robaki-dev/robak/README.md

# Robak :bug:
Robak is a DIY 4x4 all-terrain radio controlled vehicle. Designed from scratch with makers in mind - you can build one yourself.

robak

### Printed parts :car:
- Download 3D models `.zip` package from [releases](https://github.com/robaki-dev/robak/releases)

### What to print :heavy_check_mark:
- Check the [3DPartsList](3DPartsList.csv)

### Non printed parts :rocket:
- Check the [BOM](BOM.csv)
- Links available on [Discord](https://discord.gg/4mxkpQYTXy)

### Hinge pins :scissors:
- Cut steel rods to lenght: [drawing](DRAWINGS/HingePins.pdf)

### Documentation :green_book:
- [Docs](https://robaki.dev/docs) on https://robaki.dev

### Support :wave:
- Join our [Discord](https://discord.gg/4mxkpQYTXy) channel

### Video guide :video_camera:
Video Guide (https://www.youtube.com/watch?v=374VbFoaV5E)
