robaki-dev/robak/RobakPartsList.xlsx

Sheet: Non Printed Parts
Robak v2.2.0 Parts Shopping List |  |  | Created by Googliola. Last update: 12.05.2023 draft by Milosz |  |  |  |  |  | Basic edition |  | Plus edition
Category | Qty | Part name | Model | UnitPrice CHF [incl.shipping] | URLs [contains affiliate links] | Required | Status | Notes | Pick | Total | Pick | Total
Electronics
 | 1 | Transmitter & Receiver | DumboRC X4 X6 X6P 2.4G 6CH Transmitter X6F | 35.00 | https://s.click.aliexpress.com/e/_DmUJbcJ | Recommended | To order | easy to setup includes LiPo | TRUE | 35.00 | TRUE | 35.00
 | 1 | Transmitter & Receiver | Flysky FS GT3B FS-GT3B 2.4G 3CH | 31.00 | https://s.click.aliexpress.com/e/_DkLOPvt (https://vi.aliexpress.com/item/32981512042.html) | Alternative | To order | most sophisticated RC for multiple models setup more extensive / many options requires 8 (!) AA batteries | FALSE | 0.00 | FALSE | 0.00
 | 1 | Transmitter & Receiver | Droyuke New GA-4H-TX 4CH 2.4GHz Remote Control | 14.00 | https://s.click.aliexpress.com/e/_DFrT7Rz | Alternative | To order | easy to setup requires 4 AAA batteries | FALSE | 0.00 | FALSE | 0.00
 | 1 | Transmitter & Receiver | Reely Gen4 Pistolengriff-Fernsteuerung 2,4 GHz | 26.00 | https://www.conrad.ch/de/p/reely-gen4-pistolengriff-fernsteuerung-2-4-ghz-anzahl-kanaele-4-inkl-empfaenger-2267650.html | Alternative | To order | Sprinkle-resistant receiver long range Conrad Not available in all countries | FALSE | 0.00 | FALSE | 0.00
 | 1 | Battery charger | IMAX B6 Lipo Balance Charger | 21.00 | https://s.click.aliexpress.com/e/_DBvB4rZ | Recommended | To order | More sophisticated but not too complicated comes with XT60 | FALSE | 0.00 | TRUE | 21.00
 | 1 | Battery charger | HTRC S680 80W 6A AC to DC Mini RC LiPo Charger | 28.00 | https://www.banggood.com/custlink/DGvWgwlU7y | Alternative | To order | Easy to use / little control / no storage comes with T-Plug | FALSE | 0.00 | FALSE | 0.00
 | 1 | Battery charger | VOLTCRAFT V-Charge Eco LiPo 2000 | 15.00 | https://www.conrad.ch/de/p/voltcraft-v-charge-eco-lipo-2000-modellbau-ladegeraet-230-v-2-a-lipo-1409523.html | Alternative | To order | + Very basic, ideal for beginners - no discharge, store function | TRUE | 15.00 | FALSE | 0.00
 | 1 | 2S Battery | Zeee LiPo Battery 2S 6000mAh 80C XT60 Plug | 28.00 | https://s.click.aliexpress.com/e/_DBv0vof | Recommended | To order | hard case: l=138mm; w=48mm +/- 2mm | TRUE | 28.00 | TRUE | 28.00
 | 1 | 3S Battery | TBD | 28.00 | TBD | Alternative | To order |  | FALSE | 0.00 | FALSE | 0.00
 | 1 | Motor & ESC | HobbyWing MAX10 60A + 3652 3300KV | 100.00 | TBD | Recommended | To order | best value in return for your money | FALSE | 0.00 | TRUE | 100.00
 | 1 | Motor & ESC | Racerstar 3660 Brushless Motor 60A ESC Waterproof w/ M0.6 Metal Gears | 44.00 | https://www.banggood.com/custlink/3mGW6fakTJ | Alternative | To order | budget option | TRUE | 44.00 | FALSE | 0.00
 | 1 | Motor & ESC | Rocket V2 3650 3250KV 60A ESC Waterproof | 52.00 | https://s.click.aliexpress.com/e/_DeiD7vh | Alternative | To order |  | FALSE | 0.00 | FALSE | 0.00
 | 1 | Motor & ESC | Rocket V2 3650 3250KV 60A ESC Waterproof with Programming Card | 58.00 | https://s.click.aliexpress.com/e/_DEkWwQB | Alternative | To order |  | FALSE | 0.00 | FALSE | 0.00
 | 1 | Servo | rc servo 20KG DS3218 or PRO | 12.00 | https://s.click.aliexpress.com/e/_DemKoQf | Recommended | To order | cheap, reliable metal gear ,inlcludes horn | TRUE | 12.00 | TRUE | 12.00
 | 1 | Servo | Waterproof Servo DSC45MG 45KG | 35.00 | https://s.click.aliexpress.com/e/_Dmd69uR | Not Recommended | To order | too expensive servo | FALSE | 0.00 | FALSE | 0.00
 | 1 | Motor fan | HSP 03300 Aluminum Heat Sink Cooling Fan | 4.00 | https://s.click.aliexpress.com/e/_DmSxqEB | Optional | To order | NOT compatible with Rocket V2 motors | FALSE | 0.00 | FALSE | 0.00
 | 1 | Motor fan | Metal Shell 3010 ESC Motor 30mm Cooling Fan | 9.00 | https://vi.aliexpress.com/item/1005003298884797.html | Optional | To order | Good quality but expensive Different Chassis Rear Plate required! Compatible with any motor (inc Rocket V2 ) | FALSE | 0.00 | FALSE | 0.00
RC Parts
 | 1 | wheels | HSP 88005 Monster Truck | 22.00 | https://www.aliexpress.com/item/32748779556.html | Recommended | To order | 128x65mm, includes tires | TRUE | 22.00 | TRUE | 22.00
 | 1 | wheels | HSP 88030 Monster Truck | 20.00 | https://www.aliexpress.com/item/1005004166815985.html | Alternative | To order | 128x65mm, includes tires | FALSE | 0.00 | FALSE | 0.00
 | 1 | wheels | Short Course Truck Tires / Type B | 25.00 | https://www.aliexpress.com/item/1005005050521051.html | Alternative | To order | 111x45mm, normal price 45 USD | FALSE | 0.00 | FALSE | 0.00
 | 1 | wheels | Rubber Sponge Tire | 26.00 | https://s.click.aliexpress.com/e/_DBg0Bcn | Alternative | To order |  | FALSE | 0.00 | FALSE | 0.00
 | 1 | wheels | INJORA 4PCS 110*48MM | 22.00 | https://s.click.aliexpress.com/e/_Dmc1OYb | Alternative | To order | INNER DIAMETER??? | FALSE | 0.00 | FALSE | 0.00
 | 1 | wheels | HSP94166 Buggy | 12.00 | https://www.aliexpress.com/item/32755525487.html | Alternative | To order |  | FALSE | 0.00 | FALSE | 0.00
 | 4 | Rims | printed rims | 0.00 | https://www.printables.com/model/155343-300-x-1925-rims-for-robak | Optional | N/A |  | FALSE | 0.00 | FALSE | 0.00
 | 2 | servo horn | 25T, 20 and 25mm ctc distance | 3.00 | https://www.aliexpress.com/item/4000024586812.html | Optional | To order | buy unless servo comes with a horn | FALSE | 0.00 | FALSE | 0.00
 | 1 | shocks (set of 4) | INJORA Aluminum Shock Absorber 100mm | 20.00 | https://s.click.aliexpress.com/e/_DlzZ8yb | Recommended | To order |  | TRUE | 20.00 | TRUE | 20.00
 | 2 | shocks (set of 2) | INJORA Built-in Spring Shock Absorber 100mm | 8.00 | https://s.click.aliexpress.com/e/_DdWDcBX | Not Recommended | To order | coilover shocks are better | FALSE | 0.00 | FALSE | 0.00
 | 1 | shocks (set of 4) | INJORA Built-in Spring Shock Absorber100 | 16.00 | https://s.click.aliexpress.com/e/_DlzZ8yb | Not Recommended | To order | coilover shocks are better | FALSE | 0.00 | FALSE | 0.00
 | 1 | springs (set of 4) | 5858 Traxxas | 6.00 | TBD | Recommended | To order | recommended as the stock springs are too soft | TRUE | 6.00 | TRUE | 6.00
 | 1 | harder springs | INJORA Metal Shock Springs Compression 60*15mm | 5.00 | https://s.click.aliexpress.com/e/_DeXwE1l | Optional | To order |  | FALSE | 0.00 | FALSE | 0.00
 | 2 | differential | HSP 02024 | 7.00 | https://www.aliexpress.com/item/32754240421.html | Recommended | To order |  | TRUE | 14.00 | TRUE | 14.00
 | 2 | differential main gear | HSP 02029 | 3.00 | https://www.aliexpress.com/item/32754204819.html | Optional | To order | in case you damage one | FALSE | 0.00 | FALSE | 0.00
 | 1 | front & rear gear | HSP 02030 & HSP 03015 | 8.00 | https://s.click.aliexpress.com/e/_DFBlChz | Recommended | To order | e-clips included | TRUE | 8.00 | TRUE | 8.00
 | 1 | front gear | HSP 02030 | 4.00 | https://vi.aliexpress.com/item/32750973022.html | Alternative | To order | e-clips and 2x bearings included | FALSE | 0.00 | FALSE | 0.00
 | 1 | rear gear | HSP 03015 | 4.00 | https://vi.aliexpress.com/item/33030608113.html | Alternative | To order | e-clips and 2x bearings included | FALSE | 0.00 | FALSE | 0.00
 | 2 | cvd (set of 2) | HSP 108015 | 7.00 | https://www.aliexpress.com/item/1005003412783326.html | Recommended | To order | 113 and 84mm length (see pic on AliE) | TRUE | 14.00 | TRUE | 14.00
 | 1 | wheel hex (set of 4) | HSP 122042 | 1.00 | https://www.aliexpress.com/item/32750184003.html | Recommended | To order |  | TRUE | 1.00 | TRUE | 1.00
 | 1 | cups (set of 2) | HSP 02016 | 2.00 | https://www.aliexpress.com/item/32753894250.html?spm=a2g0o.cart.0.0.47aa38da7Ji0gU&mp=1 | Recommended | To order |  | TRUE | 2.00 | TRUE | 2.00
 | 1 | servo links (set of 2) | HSP 02012 | 2.00 | https://www.aliexpress.com/item/32746589847.html | Recommended | To order | only one needed | TRUE | 2.00 | TRUE | 2.00
 | 1 | steering links (set of 2) | HSP 06016 | 2.00 | https://www.aliexpress.com/item/32755140656.html?spm=a2g0o.cart.0.0.448338da3W1Opf&mp=1 | Recommended | To order | one pair | FALSE | 0.00 | TRUE | 2.00
 | 1 | drive shaft | HSP 04003 | 3.00 | https://vi.aliexpress.com/item/32755258981.html | Recommended | To order |  | TRUE | 3.00 | TRUE | 3.00
 | 1 | spur gear 64T + pinion 17T | HSP 11184 + HSP 11181 | 3.00 | https://www.aliexpress.com/item/32806354242.html | Recommended | To order | 64T + 17T | TRUE | 3.00 | TRUE | 3.00
 | 1 | spur gear 64T + pinion 21T | HSP 11181 + HSP 11181 | 3.00 | https://www.aliexpress.com/item/32806354242.html | Alternative | To order | 64T + 21T | FALSE | 0.00 | FALSE | 0.00
 | 2 | ball head (set of 4) | HSP 06007 | 3.00 | https://www.aliexpress.com/item/32757503647.html | Recommended | To order | for shocks | TRUE | 6.00 | TRUE | 6.00
 | 1 | grub screws M4x4mm (set of 10) | HSP 02099 | 2.00 | https://www.aliexpress.com/item/32752216934.html | Optional | To order | those should come with cups - HSP 02016 | TRUE | 2.00 | TRUE | 2.00
 | 1 | ball head screws (set of 6) | HSP 02038 | 3.00 | https://vi.aliexpress.com/item/32754342482.html | Recommended | To order | for steering | TRUE | 3.00 | TRUE | 3.00
 | 1 | main gear pin (set of 8) | HSP 08027 | 1.00 | https://vi.aliexpress.com/item/32757803702.html | Recommended | To order | only one needed, more is nice to have if you lose it | TRUE | 1.00 | TRUE | 1.00
Addon Parts
 | 1 | Body Lexan |  | 25.00 |  | Optional | To order |  | FALSE | 0.00 | FALSE | 0.00
 | 1 | LED Bar | Super Bright LED Light Bar RC Car Roof Lamp CH3 Control | 10.00 | https://vi.aliexpress.com/item/1005001389442914.html | Optional | To order |  | FALSE | 0.00 | FALSE | 0.00
 | 1 | Fan 3010 |  | 5.00 |  | Optional | To order | Motor cooling (is it required for selected motor?) | FALSE | 0.00 | FALSE | 0.00
 | 1 | Knog Plus | Bike ligths | 32.00 | TBD | Optional | To order |  | FALSE | 0.00 | FALSE | 0.00
Bearings
 | 1 | big bearings (set of 10) | 10x15x4mm | 7.00 | https://s.click.aliexpress.com/e/_DCUQQT1 | Recommended | To order | order a few more if you can | TRUE | 7.00 | TRUE | 7.00
 | 1 | small bearings (set of 10) | 5x10x4mm | 7.00 | https://s.click.aliexpress.com/e/_Dmg1ED5 | Recommended | To order | order a few more if you can | TRUE | 7.00 | TRUE | 7.00
Various
 | 1 | battery straps (set of 5) | 20x200mm for 2S | 3.00 | https://s.click.aliexpress.com/e/_DkWicpV | Recommended | To order | 20x250mm for 3S or larger?? | TRUE | 3.00 | TRUE | 3.00
 | 1 | sillicone oil | 700 cSt | 3.00 | https://s.click.aliexpress.com/e/_DetbLJ9 | Recommended | To order | around 3ml per one shock needed | TRUE | 3.00 | TRUE | 3.00
 | 1 | sillicone oil (diff) | 80 000 cSt | 3.00 | https://vi.aliexpress.com/item/32816969688.html | Recommended | To order | 60.000 cSt will work too | TRUE | 3.00 | TRUE | 3.00
 | 1 | sillicone oil | 500 cSt | 3.00 | https://s.click.aliexpress.com/e/_DljnS1d | Alternative | To order | around 3ml per one shock needed | FALSE | 0.00 | FALSE | 0.00
 | 1 | thread-locking fluid | Loctite 222 50ml | 2.00 | https://s.click.aliexpress.com/e/_DlNjSKr | Recommended | To order | Medium strength (blue) | TRUE | 2.00 | TRUE | 2.00
 | 1 | lithium grease |  | 2.00 | https://s.click.aliexpress.com/e/_Deq9eIR | Recommended | To order | or any other grease for gears | TRUE | 2.00 | TRUE | 2.00
 | 1 | CA glue | superglue | 1.00 | https://vi.aliexpress.com/item/32817948117.html | Recommended | To order | tire glue | TRUE | 1.00 | TRUE | 1.00
 | 1 | stainless steel rod | 500mm Ø3mm steel rod | 7.00 | https://s.click.aliexpress.com/e/_DBYA5Cf | Recommended | To order | for DIY hinge pins - drawing (https://github.com/robaki-dev/robak/blob/main/DRAWINGS/HingePins.pdf) | TRUE | 7.00 | TRUE | 7.00
Fasteners
 | 8 | M2x10mm Socket Head Screws (Set of 50) | DIN 912; ISO 4762 | 2.00 | https://s.click.aliexpress.com/e/_DeejcYL | Recommended | To order | bolt 2 body parts together | TRUE | 2.00 | TRUE | 2.00
 | 8 | M2 Nylon-Insert Locknuts (Set of 50) | DIN 985; ISO 10511 | 2.00 | https://s.click.aliexpress.com/e/_DEDlJZh | Recommended | To order | bolt 2 body parts together | TRUE | 2.00 | TRUE | 2.00
 | 12 | M3x25mm Socket Head Screws (Set of 50) | DIN 912; ISO 4762 | 2.00 | https://s.click.aliexpress.com/e/_DBopwOP | Recommended | To order |  | TRUE | 2.00 | TRUE | 2.00
 | 4 | M3x20mm Socket Head Screws (Set of 50) | DIN 912; ISO 4762 | 2.00 | https://s.click.aliexpress.com/e/_DBopwOP | Recommended | To order |  | TRUE | 2.00 | TRUE | 2.00
 | 9 | M3x16mm Socket Head Screws (Set of 50) | DIN 912; ISO 4762 | 2.00 | https://s.click.aliexpress.com/e/_DBopwOP | Recommended | To order |  | TRUE | 2.00 | TRUE | 2.00
 | 8 | M3x12mm Socket Head Screws (Set of 50) | DIN 912; ISO 4762 | 2.00 | https://s.click.aliexpress.com/e/_DBopwOP | Recommended | To order |  | TRUE | 2.00 | TRUE | 2.00
 | 2 | M3x10mm Socket Head Screws (Set of 50) | DIN 912; ISO 4762 | 2.00 | https://s.click.aliexpress.com/e/_DBopwOP | Optional | To order | For motor to plate, 10mm is better than 8mm. | TRUE | 2.00 | TRUE | 2.00
 | 8 | M3x25mm Flat Head Screws (Set of 50) | DIN 7991; ISO 10642 | 2.00 | https://s.click.aliexpress.com/e/_DkKbSjv | Recommended | To order | three-piece diff case | TRUE | 2.00 | TRUE | 2.00
 | 4 | M3x20mm Flat Head Screws (Set of 50) | DIN 7991; ISO 10642 | 2.00 | https://s.click.aliexpress.com/e/_DkKbSjv | Recommended | To order | 60pcs, diff case to chassis | TRUE | 2.00 | TRUE | 2.00
 | 10 | M3x16mm Flat Head Screws (Set of 50) | DIN 7991; ISO 10642 | 2.00 | https://s.click.aliexpress.com/e/_DkKbSjv | Recommended | To order |  | TRUE | 2.00 | TRUE | 2.00
 | 18 | M3x12mm Flat Head Screws (Set of 50) | DIN 7991; ISO 10642 | 2.00 | https://s.click.aliexpress.com/e/_DkKbSjv | Recommended | To order |  | TRUE | 2.00 | TRUE | 2.00
 | 1 | M3x8mm Flat Head Screws (Set of 50) | DIN 7991; ISO 10642 | 2.00 | https://s.click.aliexpress.com/e/_DkKbSjv | Recommended | To order |  | TRUE | 2.00 | TRUE | 2.00
 | 53 | M3 Thin Square Nuts (h: 1.8mm) (Set of 50) | DIN 562 | 4.00 | https://s.click.aliexpress.com/e/_DlKzA3v | Recommended | To order |  | TRUE | 4.00 | TRUE | 4.00
 | 4 | M3 Nylon-Insert Locknuts (Set of 50) | DIN 985; ISO 10511 | 2.00 | https://s.click.aliexpress.com/e/_Dd4urPV | Recommended | To order | for upper arm hinge | TRUE | 2.00 | TRUE | 2.00
 | 18 | M3 General Purpose Washers (Set of 100) | DIN 125; ISO 7089 | 2.00 | https://s.click.aliexpress.com/e/_DB11JX9 | Recommended | To order | motor mount to the plate | TRUE | 2.00 | TRUE | 2.00
 | 4 | M4 Nylon-Insert Locknuts (Set of 50) | DIN 985; ISO 10511 | 2.00 | https://s.click.aliexpress.com/e/_Dd4urPV | Recommended | To order | for wheels | TRUE | 2.00 | TRUE | 2.00
 | 4 | M4 General Purpose Washers | DIN 125; ISO 7089 | 2.00 | https://s.click.aliexpress.com/e/_DB11JX9 | Recommended | To order | for wheels | TRUE | 2.00 | TRUE | 2.00
 | 1 | M6x20 Flange Head Bolt | DIN 6921 | 0.20 |  | Optional | To order | for v2.1.0 body | FALSE | 0.00 | FALSE | 0.00
 | 1 | M6x35 Flange Head Bolt | DIN 6921 | 0.20 |  | Optional | To order | for v2.1.0 body | FALSE | 0.00 | FALSE | 0.00
Filament
 | 2 | Filament you know and like | PCTG/PETG/PLA+/PC/PA12/Any | 25.00 |  | Recommended | To order | You can't go wrong with filament you know | TRUE | 50.00 | FALSE | 0.00
 | 1 | PCTG | Nobufil PCTG | 30.00 | https://www.nobufil.com/en/pctg | Alternative | To order | In my opinion the best all-purpose material for Robak. Nobufil promo code for Robak community: https://discord.com/channels/816386800820944936/1062027777718616184/1068103536904245308 | FALSE | 0.00 | TRUE | 30.00
 | 1 | PCTG | Fiberlogy PCTG | 30.00 | https://fiberlogy.com/en/fiberlogy-filaments/pctg/ | Alternative | To order | Fiberlogy transparent color PCTG works great for Robak's body | FALSE | 0.00 | TRUE | 30.00
 | 1 | PA12+GF | Fiberlogy PA12+GF | 39.00 | https://fiberlogy.com/en/fiberlogy-filaments/nylon-pa12gf/ | Alternative | To order | high durability and heat resistance. Requires hardened steel or ruby nozzle | FALSE | 0.00 | TRUE | 39.00
 | 1 | PA12 | Fiberlogy PA12 | 39.00 | https://fiberlogy.com/en/fiberlogy-filaments/nylon-pa12/ | Alternative | To order | best layer adhesion and impact resistance | FALSE | 0.00 | TRUE | 39.00
Tools
 | 1 | Xiaomi Worx 4V | Mini Electrical Screwdriver Set WX242 | 56.00 | https://s.click.aliexpress.com/e/_DedOjht | Optional | To order | Excellent quality, includes bits | FALSE | 0.00 | FALSE | 0.00
 | 1 | Electric Screwdriver | Includes 28 bits | 23.00 | https://s.click.aliexpress.com/e/_DkTZr0P | Optional | To order |  | FALSE | 0.00 | FALSE | 0.00
 |  |  |  |  |  |  |  | TOTAL | CHF | 327.00 | CHF | 479.00

Sheet: Printed Parts
Printed Parts List
Part name | Qty | Required | Changed in version | Status | Recommended Materials | Filament | Supports | Notes
ArmFL.stl | 1 | Yes | 2.2.0 | FALSE | PCTG/PETG/PLA+ | PCTG Grey | No
ArmFR.stl | 1 | Yes | 2.2.0 | FALSE | PCTG/PETG/PLA+ | PCTG Grey | No
ArmRL.stl | 1 | Yes | 2.2.0 | FALSE | PCTG/PETG/PLA+ | PCTG Grey | No
ArmRR.stl | 1 | Yes | 2.2.0 | FALSE | PCTG/PETG/PLA+ | PCTG Grey | No
BatteryHolder_1.stl | 2 | Yes | 2.2.0 | FALSE | PCTG/PETG/PLA+ | PCTG Grey | No
BatteryHolder_2.stl | 1 | Yes | 2.2.0 | FALSE | PCTG/PETG/PLA+ | PCTG Grey | No
BatteryHolder_3.stl | 1 | Yes | 2.2.0 | FALSE | PCTG/PETG/PLA+ | PCTG Grey | No
BellCrankL.stl | 1 | Yes | 2.2.0 | FALSE | PA12+GF/PA12/PC/HardTPU | PA12+GF | No | impact resistant material
BellCrankR.stl | 1 | Yes | 2.2.0 | FALSE | PA12+GF/PA12/PC/HardTPU | PA12+GF | No | impact resistant material
BodyClip.stl | 1 | Yes | 2.2.0 | FALSE | TPU/PA12 | TPU 40D | No
BodyClip_2.stl | 1 | Optional | 2.2.0 | FALSE | PETG/PCTG | PCTG Black | No | option for less flexible materials
BodyF.stl | 1 | Yes | 2.2.0 | FALSE | PETG/PCTG | PCTG Orange | No
BodyGroove.stl | 1 | Yes | 2.2.0 | FALSE | TPU/PET/PCTG | TPU 40D | No
BodyR.stl | 1 | Yes | 2.2.0 | FALSE | PETG/PCTG | PCTG Orange | No
Brace.stl | 2 | Yes | 2.2.0 | FALSE | PCTG/PETG/PLA+ | PCTG Grey | No
Brace_KNOG.stl | 2 | Optional | 2.2.0 | FALSE | PCTG/PETG/PLA+ | PCTG Grey | No | optional Knog Plus LED
1_Calibration.stl | 1 | Yes | 2.2.0 | FALSE | PCTG/PETG/PLA+ | PCTG Grey | No
CarrierHubF.stl | 2 | Yes | 2.2.0 | FALSE | PA12+GF/PCTG/PC | PA12+GF | No
CarrierHubR.stl | 2 | Yes | 2.1.0 | FALSE | PCTG/PETG/PLA+ | PCTG Black | No
CentralSupport.stl | 2 | Yes | 2.2.0 | FALSE | PCTG/PETG/PLA+ | PCTG Black | No
ChassisF.stl | 1 | Yes | 2.2.0 | FALSE | PCTG/PETG/PLA+ | PCTG Blue | No
ChassisR.stl | 1 | Yes | 2.2.0 | FALSE | PCTG/PETG/PLA+ | PCTG Blue | No
DiffCaseHeadSide.stl | 2 | Yes | 2.2.0 | FALSE | PCTG/PETG/PLA+ | PCTG Grey | No
DiffCaseMiddlePart.stl | 2 | Yes | 2.2.0 | FALSE | PCTG/PETG/PLA+ | PCTG Grey | Yes
DiffCaseNutSide.stl | 2 | Yes | 2.2.0 | FALSE | PCTG/PETG/PLA+ | PCTG Grey | No
LEDClip_KNOG.stl | 2 | Optional | 2.0.0 | FALSE | PA12/TPU | PA12 Natural | Yes | optional Knog Plus LED
Link.stl | 1 | Yes | 2.2.0 | FALSE | PCTG/PETG/PLA+ | PA12 Natural | No
MotorPlate.stl | 1 | Yes | 2.2.0 | FALSE | PA12+GF/ABS/ASA/PC+GF | PA12+GF | No | heat resistant material
ServoMount.stl | 1 | Yes | 2.2.0 | FALSE | PCTG/PETG/PLA+ | PCTG Grey | No
SteeringBlockL.stl | 1 | Yes | 2.2.0 | FALSE | PA12/HardTPU | PA12 Natural | Yes | best layer adhesion and impact resistance
SteeringBlockR.stl | 1 | Yes | 2.2.0 | FALSE | PA12/HardTPU | PA12 Natural | Yes | best layer adhesion and impact resistance
Stem.stl | 2 | Yes | 2.2.0 | FALSE | PA12/PC/PCTG | PA12 Natural | No | best layer adhesion and impact resistance
TopDeckF.stl | 1 | Yes | 2.2.0 | FALSE | PCTG/PETG/PLA+ | PCTG Black | No
TopDeckR.stl | 1 | Yes | 2.2.0 | FALSE | PCTG/PETG/PLA+ | PCTG Black | No
Tower.stl | 2 | Yes | 2.2.0 | FALSE | PA12+GF/HardTPU/PC/PCTG | PA12+GF | No | impact resistant material
UpperArmFL.stl | 1 | Yes | 2.2.0 | FALSE | PCTG/PETG/PLA+ | PCTG Blue | No
UpperArmFR.stl | 1 | Yes | 2.2.0 | FALSE | PCTG/PETG/PLA+ | PCTG Blue | No
UpperArmRL.stl | 1 | Yes | 2.2.0 | FALSE | PCTG/PETG/PLA+ | PCTG Blue | No
UpperArmRR.stl | 1 | Yes | 2.2.0 | FALSE | PCTG/PETG/PLA+ | PCTG Blue | No
