robaki-dev/robak/(list of files, cad)

Other CAD files:
STL/Tower.stl
STL/BellCrankR.stl
STL/BodyR.stl
STL/SteeringBlockR.stl
STL/BodyF.stl
STL/ServoMount.stl
STL/Link.stl
STL/CarrierHubR.stl
STL/LEDClip_KNOG.stl
STL/UpperArmRL.stl
STL/Brace_KNOG.stl
STL/CarrierHubF.stl
STL/BodyClip.stl
STL/ChassisR.stl
STL/ChassisF.stl
STL/UpperArmFR.stl
STL/BellCrankL.stl
STL/DiffCaseHeadSide.stl
STL/BodyGroove.stl
STL/BatteryHolder_3.stl
STL/TopDeckR.stl
STL/ArmRL.stl
STL/DiffCaseNutSide.stl
STL/BatteryHolder_2.stl
STL/DiffCaseMiddlePart.stl
STL/CentralSupport.stl
STL/1_Calibration.stl
STL/UpperArmFL.stl
STL/BatteryHolder_1.stl
STL/TopDeckF.stl
STL/ArmFR.stl
STL/SteeringBlockL.stl
STL/ArmFL.stl
STL/Stem.stl
STL/Brace.stl
STL/UpperArmRR.stl
STL/MotorPlate.stl
STL/BodyClip_2.stl
STL/ArmRR.stl
