robaki-dev/robak/(threads)

Thread 1 (2021-06-07):

Not enough room for HSP 108015

robaki-dev, 2021-06-07:
### affects version
 v1.1

##### hotfix v1.1.1 will be released as soon this is done

### description
HSP 108015 shaft pushes and blocks on the differential cup when suspension arms in extreme position.

### solution
Extend hubs and move CVDs 1.5mm to the outside.

### following parts will change
- SteeringHub
- CarrierHubRearLeft
- CarrierHubRearRigth

Closed 2021-06-13.

Thread 11 (2021-06-07):

Use larger outer bearings for the drive gears

robaki-dev, 2021-06-07:
Sometimes the main gear pin rubs agains 5x10x4 outer bushing

robaki-dev, 2021-12-08:
5x10x4 works just fine if diff case printed and assembled properly

Closed 2021-12-08.

Thread 2 (2021-06-07):

Weak connection between Chassis and BraceBigPart

robaki-dev, 2021-06-07:
### description
Sometimes, when hit head-on, the 4 short screws pull off from the Brace and the whole front end separates from the Chassis.

### solution
M3 threaded inserts or hex nuts in the BraceBigPart

Closed 2021-08-15.

Thread 3 (2021-06-07):

Body does not sit tight

robaki-dev, 2021-06-07:
### description
When driving, the Body often falls off. Doesn't fit together with the v1.2 TopDeck

### solution
Attach using clips or magnets. Make some room for the heat sink.

Closed 2021-08-15.

Thread 6 (2021-06-07):

Differential is slightly shifted to the left

robaki-dev, 2021-06-07:
I noticed the optimal position for the differential is off the diff case center. That means the left differential cup sticks out more from the diff case (~1mm).

When pushing the differential back to the center, the gears start jamming.
I won't fix that unless it turn out the backlash was too big.

robaki-dev, 2021-12-08:
fixed in v2

Closed 2021-12-08.

Thread 7 (2021-06-07):

LowerDiffCase horizontal holes diameter is too big

robaki-dev, 2021-06-07:
is 3mm, should be 2.5mm

robaki-dev, 2021-06-16:
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

Closed 2021-06-16.

Thread 12 (2021-06-10):

Gap between arms and carrier hubs

robaki-dev, 2021-06-10:
### description
There is too much play between suspension arms and carrier hubs both on front and rear.

### workaround
Use 1 or 2 M4 washers.

### solution
1.6mm less distance in the wishbones carrier hub slots

robaki-dev, 2021-06-16:
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

Closed 2021-06-16.

Thread 13 (2021-06-13):

Shock cap rubs against Tower

robaki-dev, 2021-06-13:
### description
This puts some tension on the shaft

### solution
- higher Tower bumps
or
- a spacer between the tower and shock's ball head

robaki-dev, 2021-06-16:
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

Closed 2021-06-16.

Thread 15 (2021-06-14):

Thicker Top Deck

robaki-dev, 2021-06-14:
### description
Currently it's 3mm and often breaks in head-on collisions

### solution
- ~5mm thick
- in 2 parts- easier to print (?)

robaki-dev, 2021-06-15:
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

robaki-dev, 2021-06-16:
[TopDeck_v1.2.0-alpha.zip](https://github.com/robaki-dev/robak/files/6662341/TopDeck_v1.2.0-alpha.zip)

Closed 2021-06-16.

Thread 18 (2021-11-24):

Splitted body

buldo, 2021-11-24:
Current body is really big.
I can split it into 2 parts in 3D Builder, print and glue together.
But I think You can design smth better. Maybe shaft or bolted joints...

robaki-dev, 2021-11-24:
Surely Robak deserves a better body! I don't like current design either. I have sth in mind and I'm going to share it as soon it's ready. Thanks for the feedback!

buldo, 2021-12-10:
@robaki-dev right now my printer is broken. New part is on the way from China. I'll try as soon as possible later this month.

buldo, 2021-12-26:
@robaki-dev I tried new design. It is good and works. But there are some issues:

- this is only part that use M2 screws. This extends BOM. (And for me this is a bit harder to find M2 in my screw collection)
- this design requires ideal bed leveling( maybe it shoud be printed in some special orientation)
- it hard to assemble

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

buldo, 2024-01-02:
@robaki-dev after long time I tried splitted body from 2.2.0 release.
I printed it from PETg.
Strange, but looks like two parts holes not fits

robaki-dev, 2024-01-02:
You're right! I'll get that fixed soon. Thanks for pointing this out.

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

muraj, 2024-01-03:
Yeah, I had a hard time lining this up as well.  Managed to get 4/6 screws lined up, but I think that misaligned the outside.  Anyway, looking forward to new body!

cnrd, 2024-01-03:
I also had issues getting the screws in, when I tried the 2 part body.

Looking closely at the two halves, I have found a couple of other differences where the models does not align.

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

robaki-dev, 2024-01-07:
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
Fixed the alignment of the holes. Files are now available on Printables and in the release ZIP. Thanks!

ziguana, 2024-01-07:
i thought it was my fault that the holes didn't line up. thank you for fixing this!

Closed 2024-01-07.

Thread 19 (2021-12-05):

Make CHub stronger

heminei, 2021-12-05:
Very often CHub brokes. I have modified the center hole: I made it smaller. Also, I increased the wall thickness where is placed the hole.

I have attached my modified version.
[Robak - CHubs - stronger.zip](https://github.com/robaki-dev/robak/files/7655871/Robak.-.CHubs.-.stronger.zip)

robaki-dev, 2021-12-08:
Hi, thanks for fixing that!
Cause I'm currently working on the v2 I don't have any compatible v1 Robak on hand to test your design.

What about publishing this as a remix on Thingiverse? If you don't have an account or just want me to do that for you let me know. I'm not going to make any further releases of v1 so that would be the easiest way to share your upgrade.

heminei, 2021-12-08:
Hi,
I have published a remix: [](https://www.thingiverse.com/thing:5159148)

Closed 2021-12-08.

Thread 22 (2022-10-01):

Diffs might need to be reversed

crabbedh, 2022-10-01:
For my sensored motor pair, I had to reverse both differentials from the drawing you posted to me on Discord.. I did not check the actual step file, but you might not have considered that sensored motor/esc pairs usually (and I'm assuming here.. I don't really know this) turn motor in one direction ONLY. Switching motor leads is NOT an option.. unless you also want to rewire the sensor cable AND fiddle with the timing which is now changed from the marking on the case.. (not a real option).

You might want to have a "live" document that provides build advice and is updated when needed.. 3D Sets does this with their build guides, so when you get it from the net, it is always up to date.. You can put things on it like screw lengths that are not obvious from video; and things like the diff direction.

robaki-dev, 2022-10-14:
Thanks! Updated https://robaki.dev/docs/assembly/ page with an advice how to choose the right diffs direction for a given motor rotation.

I'm going to prepare drawings with screw lengths as I did for the three-piece-diffcase mod. Then I'll start thinking what's the best way to publish it 😉

Closed 2022-10-14.

Thread 28 (2022-12-29):

Motorblock & spur gear bearing missing / incompatible

apphead, 2022-12-29:
During my build I was struggling with how the spur gear axis is "connected" to the motorblock. Intuitively, I wanted to fit a second, bigger bearing into that hole but my 5x16x5mm bearings I have left from my printers just would not fit. And it is not in the design files either - on purpose?
Anyway, I am going to adjust the design and increase the inner hole by 1mm to 16. Dunno if it is a bug or not intended to contain a bearing, but I will try it anyway. I think it relieves some pressure from the small bearing next to it.

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

apphead, 2022-12-30:
There is not enough space to fit a 5mm bearing. But I'm not 100% happy with the current solution. Closing for now as my suggestion is invalid.

robaki-dev, 2023-01-02:
yes, that hole was not intended to contain a bearing. Its size was an arbitrary choice just to make some room for the spur gear.
sometimes the spur gear goes in like that:
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

Closed 2022-12-30.

Thread 29 (2022-12-29):

Collaboration process

apphead, 2022-12-29:
I am a huge fan of your design and will come up with some addons / improvements over the months to come. Is there a good way to collaborate with you over Fusion360 (I'm just an enthusiast with 8 years of 3d printing experience, not a pro). Github probably not an efficient path!? If you welcome my input and know a process, let me know.
Current list of todo's / issues:
- Bearing motorblock (above)
- Minor improvs: stronger battery mounts (broke off after 10mins) & adjust topdeck wire holes for my Rocket 540 V3
- Bellcranks with nuts
- Distance servolink to topdeck too close
- Front bumper
- LED bar: magnetic mount (attachable)
- New body  with rollcage [https://github.com/robaki-dev/robak/issues/18](url)
- Spoiler
- Attachable Gearbox Cover (as posted on Discord)
- Wheelie Roll Bar (maybe)

If there is an overlap with your current efforts, please let me know.

maciejwitalinski, 2022-12-30:
Gearbox cover for the 2.1 version will be much appreciated.
There is one another issue - the airflow could be better to cool down the motor. With the standard cover the motor can get too hot even with 17T gear.

Cheers,
Makavelli

robaki-dev, 2023-01-02:
Hi! I would really like to integrate your (and other people's) work into the design. I don't think Fusion360 (non-commercial) supports collaboration but we can find a way around though.

Since I don't make many modifications to the project at this point I can save it as is and handover to you. After a week or two, when you're done with modifications, you will send it back to me and your version will become the latest one.
This method may seem archaic, but I cannot come up with a better solution right now 😉

Modifications could be published as remixes (separate parts) or kept until next Robak 2.x release.

Some parts like bumpers and wings I would prefer to keep as optional, as they may not work for everyone. We can discuss the details later.

Many thanks for the feedback and support @apphead, really appreciate it!

apphead, 2023-01-03:
> Gearbox cover for the 2.1 version will be much appreciated. There is one another issue - the airflow could be better to cool down the motor. With the standard cover the motor can get too hot even with 17T gear.

True, I noticed that the 17.5T motor gets hot with 21T Pinion on 2S. As suggested on discord, I'll add a fan. But a better airflow would certainly be a good idea too. I put it on my todo list

> Hi! I would really like to integrate your (and other people's) work into the design. I don't think Fusion360 (non-commercial) supports collaboration but we can find a way around though.
I have Educational license and I can invite somebody to my fusion project - no idea if that makes it possible to collab, but it's worth a try!? If it is fine by you, DM your (Fusion Login-) email on discord. I go by the name of Googliola or I can send you my email if you prefer - your nickname on discord is milosz, right?

robaki-dev, 2023-01-05:
on my side it looks like this 😞:
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

apphead, 2023-01-05:
Hmm, bummer. Maybe editing works if I invite you?

Closed 2023-01-29.

Thread 30 (2023-06-16):

I can't clone repo with LFS data

prepor, 2023-06-16:
Hello!

During a cloning, I got this message:

> Error downloading object: DRAWINGS/HingePins.pdf (04f637b): Smudge error: Error downloading DRAWINGS/HingePins.pdf (04f637b836a2dc1a01f305a50a70553f9a62fe9e067daa620919f41b51f7a4f9): batch response: This repository is over its data quota. Account responsible for LFS bandwidth should purchase more data packs to restore access.

Is this a problem on my side or github is actually limiting this repo?

prepor, 2023-06-16:
Downloading from Releases also doesn't give me real files (stl, step), only some meta data

prepor, 2023-06-16:
Ok, dowloding beta works fine [Robak_v2.2.0-beta.zip](https://github.com/robaki-dev/robak/releases/download/v2.2.0-beta/Robak_v2.2.0-beta.zip), but not source files. And it doesn't include step files

prepor, 2023-06-16:
The direct link from here https://robaki.dev/docs/download/ isn't working either

robaki-dev, 2023-06-17:
Hi @prepor,

It's on my side. Git LFS stopped working because I didn't pay for it this month 😅
Added Robak_v2.1.0.zip in releases. It includes STEP for v2.1. Just ignore `Source Code.zip` - I cannot disable it from the release,
STEP file for v2.2 will be added when it get out of beta version.

Fixed links on https://robaki.dev/docs/download/

Thanks!

Closed 2023-06-17.

Thread 31 (2023-09-29):

No step file for 2.2.0-beta branch

wathiede, 2023-09-29:
The step file is nice for people who want to adjust parts or design accessories in context. The `main` branch has `STEP/robak_v2.1.0.step` it would be nice is the 2.2.0 branch also had a step file that matched the `.stl` files.

robaki-dev, 2023-09-29:
Hi, I uploaded `Robak_v2.2.0-beta.step` as a separate asset in https://github.com/robaki-dev/robak/releases/

I have Git LFS enabled for this repository which cannot be switched back. It has 1GB bandwidth per month limit unless you pay for more.
If the step file was under version control each clone would consume >50MB of LFS bandwidth. That still happens for v2.1.0 (and I run out of bandwidth every month 😄).
It won't count if you download `.zip` or `.step` from Releases/Assets/

direct download link: https://github.com/robaki-dev/robak/releases/download/v2.2.0-beta/Robak_v2.2.0-beta.step

Closed 2023-09-29.

Thread 33 (2024-01-02):

Embossing on arms

buldo, 2024-01-02:
Hello.
I think that small embossing on arms will be useful.
Smth like "FR" for front-right.
Arms looks same for not skilled user like me. So I printed it one by one an marked arms to not make mistake.
With embossing like on new diff I can print all arms at onse and not afraid build mistakes

Thread 34 (2024-11-20):

Main body as one piece

JendaDH, 2024-11-20:
Hi,

is it possible to have a STL model of the body parts (bodyF & bodyR) as one combined piece for larger printers?
I can eventually join myself and link with this repo. Just wondering if that makes sense.

Thanks.
J.

robaki-dev, 2024-11-20:
Hi! Here you go. There’s also a one piece low profile body I like better because it’s much lighter. The only thing is, I haven’t nailed down the best mounting system for it yet. I’m working on it, though and it should be good to go in a few days.

I’m sharing the link to the Discord post since I can’t upload the STL directly here, hope that works for you!
https://discord.com/channels/816386800820944936/892053093095727125/1160197737753624616
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

low profile body:
https://discord.com/channels/816386800820944936/958706795940024350/1200798712205672548
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

JendaDH, 2024-11-20:
Thanks 👍J. On 20. 11. 2024, at 11:40, Miłosz Nowak ***@***.***> wrote:
Hi! Here you go. There’s also a one piece low profile body I like better because it’s much lighter. The only thing is, I haven’t nailed down the best mounting system for it yet. I’m working on it, though and it should be good to go in a few days.
I’m sharing the link to the Discord post since I can’t upload the STL directly here, hope that works for you!
https://discord.com/channels/816386800820944936/892053093095727125/1160197737753624616
image.png (view on web)
low profile body:
https://discord.com/channels/816386800820944936/958706795940024350/1200798712205672548
image.png (view on web)

—Reply to this email directly, view it on GitHub, or unsubscribe.You are receiving this because you authored the thread.Message ID: ***@***.***>

Closed 2024-12-18.
