robaki-dev/robak/(commit log)

2021-05-28 Add BOM.csv
    [BOM.csv]
2021-05-28 Add a newline at the end of BOM.csv
    [BOM.csv]
2021-05-29 Add 3D Parts List
    [3DPartsList.csv]
2021-05-29 Update BOM
    [BOM.csv]
2021-06-13 Fix Not enough room for HSP 108015 #1
    [3DPartsList.csv]
2021-09-15 New release v1.2
    [3DPartsList.csv]
2021-10-09 Fix typo TRX5859
    [BOM.csv]
2021-11-24 Add v2 BOM
    [BOM.csv]
2021-12-05 release v2.0.0-beta
    [3DPartsList.csv, BOM.csv]
2022-01-14 Update BOM and 3DPrintedParts
    [3DPartsList.csv, BOM.csv]
2022-01-17 Add CA glue to BOM
    [BOM.csv]
2022-03-30 Remove ITEM column from BOM.csv
    [BOM.csv]
2022-03-30 Add missing BOM parts
    [BOM.csv]
2022-10-15 Add STLs
    [ArmFL.stl, ArmFR.stl, ArmRL.stl, ArmRR.stl, BatteryMount_1.stl, BatteryMount_2.stl, BatteryMount_3.stl, BellCrankL.stl]
2022-10-15 Add HingePins.pdf
2022-10-15 Add robak_v2.1.0.step
    [robak_v2.1.0.step]
2022-10-16 M6 bolts and nuts are needed to mount the body
    [BOM.csv]
2023-06-07 Release v2.2.0-beta
    [1_Calibration.stl, 3DPartsList.csv, ArmFL.stl, ArmFR.stl, ArmRL.stl, ArmRR.stl, BOM.csv, BatteryHolder_1.stl]
